mike-rankin/ESP32_CoinCell/Images/Bottom_Side.jpg

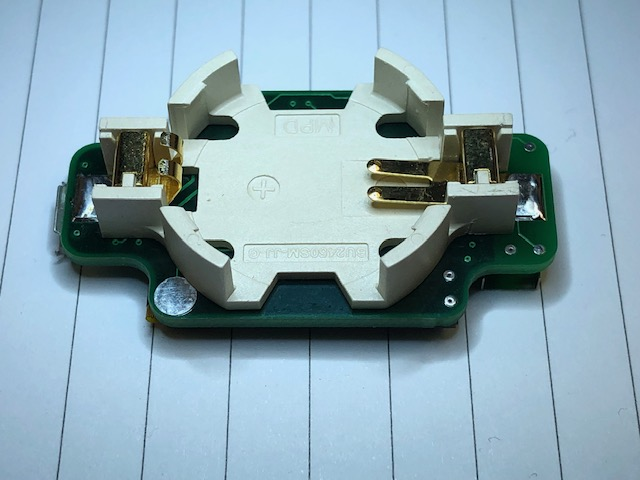
Images/Bottom_Side.jpg
