mike-rankin/ESP32_CoinCell/Images/Top.jpg

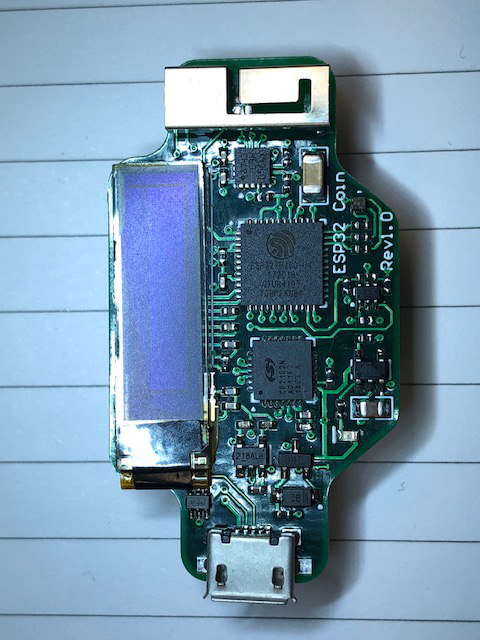
Images/Top.jpg
