mike-rankin/ESP32_CoinCell/PCB/Schematic_Rev4.pdf

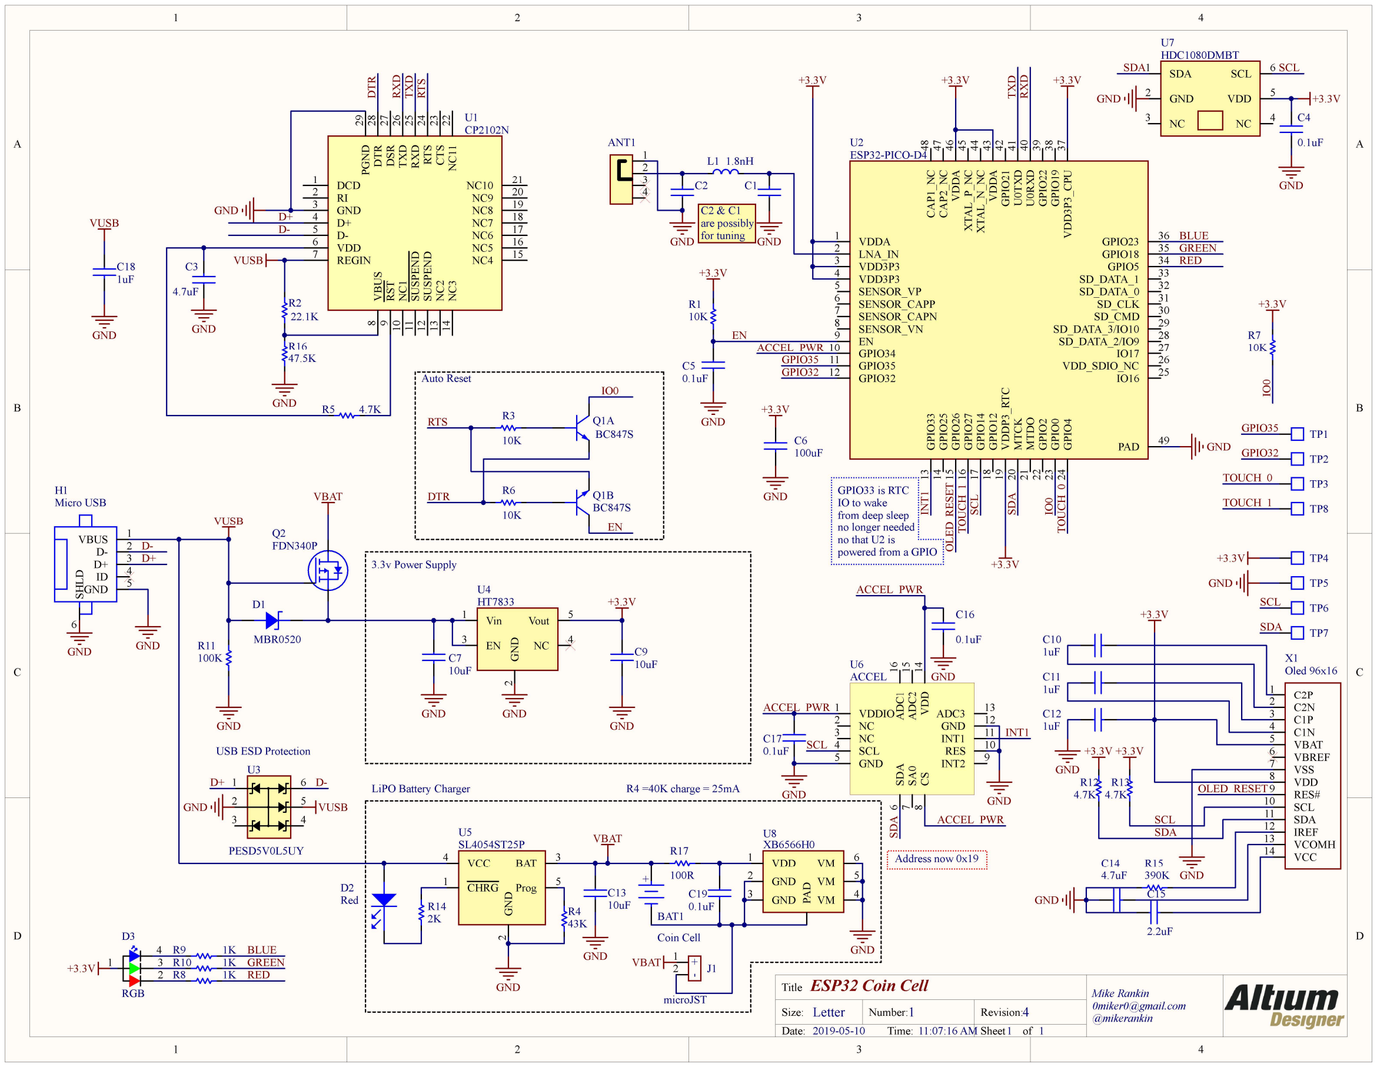
[picture p3: page 1]

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
Mike Rankin
0miker0@gmail.com
@mikerankin
1

## ESP32 Coin Cell

1 4
2019-05-10 | 11:07:16 AM

Title

Size: | Number:
Date:

Revision:
Time: | Sheet | of

Letter

+

BAT1

DCD 1

CP2102N

RI 2
GND 3
D+ 4
D- 5
VDD 6
REGIN 7 | VBUS

### 8 RST

### 9 NC1 10 SUSPEND 11 SUSPEND 12 NC2 13 NC3 14

NC4 | 15 NC5 | 16 NC6 | 17 NC7 | 18 NC8 | 19 NC9 | 20 NC10 | 21 NC¹¹ ²² CTS ²³ RTS ²⁴ RXD ²⁵ TXD ²⁶ DSR ²⁷ DTR ²⁸ PGND ²⁹ | U1

GND

10K

R3

10K

R6

D-

D+ | DTR | RTS
GND | RXD TXD

DTR

RTS

GND

VUSB

PESD5V0L5UY

1
2
3

6
5
4

U3

BC847S

Q1A

BC847S

Q1B

VUSB

GND

3.3v Power Supply

43K

R4

GND

10uF

C13

GND

2K

R14 Red

D2

GND

VBAT

LiPO Battery Charger | R4 =40K charge = 25mA

D1

MBR0520

+3.3V

VBUS | 1
D- | 2
D+ | 3
GND | 5
ID | 4

Micro USB SHLD

6

H1

GND

Coin Cell

FDN340P

Q2

VBAT

100K

R11

GND

D-D+

+3.3V | R10 | 1K
| R9 | 1K
| R8 | 1K

BLUE

1
2
3
4

ANT1

10K

R1

0.1uF

C5

GND

+3.3V

C2

GND | GND
+3.3V | +3.3V | +3.3V

+3.3V

10K

R7

+3.3V SCL | SDA | IO⁰ TXD RXD

GND

+3.3V

GND

100uF

C6

GND

GND

+3.3V

OLED_RESET

SCL
SDA

+3.3V +3.3V

C2P 1
C2N 2
C1P 3
C1N 4
VBAT 5
VBREF 6

VDD 8
RES# 9
SCL 10
SDA 11
IREF 12
VCOMH 13
VCC 14

VSS 7

X1
Oled 96x16

1uF

C10

1uF

C11

1uF

C12

4.7K

R12
4.7K

R13

390K

R15
4.7uF

C14

2.2uF

C15

VUSB | EN
IO0 | IO⁰

GND

USB ESD Protection

Auto Reset

VDDIO 1
NC 2
NC 3
SCL 4
GND 5 | SDA

### 6 SA0 7 CS

8

INT2 | 9
RES | 10 INT1 | 11 GND | 12 ADC3 | 13 VDD ¹⁴ ADC² ¹⁵ ADC¹ ¹⁶U6
ACCEL

INT1
SCL | SDA

0.1uF

C16

0.1uF

C17

GND

GND | GND

GPIO33 is RTC
IO to wake
from deep sleep
D+ | D- | TOUCH_0 OLED_RESET | TP3 TOUCH_0
+3.3V | TP4
GND | TP5
| TP6
| TP7

SCL

SDA INT¹

TP1

TP2

GPIO35
GPIO32

GPIO35

GPIO32

1

4
3
2

D3

RGB

GREEN

BLUE
GREEN

RED

RED

4.7uF

C3

R5 4.7K

22.1K

R2

47.5K

R16

GND

1uF

C18

VUSB

GND

HDC1080DMBT
SDA 1

GND 2

NC 3 | NC | 4
| SCL | 6
| VDD | 5

U7

+3.3V

0.1uF

C4

GND

GND

SDA | SCL TOUCH_1 | TP8 TOUCH_1

1
2 - +
J1

0.1uF

C19

100R

R17

VBAT

VCC 4

CHRG 1 | GND

2

BAT | 3
Prog | 5

SL4054ST25P

U5

10uF

C7 | 10uF C9
GND | GND
GND

XB6566H0
VDD 1

GND 3

GND 2 | VM | 5
| VM | 4
VM | 6 PAD

U8

EN

Address now 0x19

microJST

HT7833
Vin 1
EN 3 | GND

2

Vout | 5
NC | 4
U4 | ACCEL_PWR

ACCEL_PWR

ACCEL_PWR

ACCEL_PWR

L1 1.8nH

C1

C2 & C1
are possibly
for tuning

no longer needed
no that U2 is
powered from a GPIO

VDDA 1

PAD 49

LNA_IN 2
VDD3P3 3
VDD3P3 4
SENSOR_VP 5
SENSOR_CAPP 6
SENSOR_CAPN 7
SENSOR_VN 8
EN 9
GPIO34 10
GPIO35 11
GPIO32 12 | GPIO³³ 13 GPIO²⁵ 14 GPIO²⁶ 15 GPIO²⁷ 16 GPIO¹⁴ 17 GPIO¹² 18 VDDP³_RTC 19 MTCK 20 MTDO 21 GPIO² 22 GPIO⁰ 23 GPIO⁴ 24
IO16 | 25 VDD_SDIO_NC | 26 IO17 | 27 SD_DATA_2/IO9 | 28 SD_DATA_3/IO10 | 29 SD_CMD | 30 SD_CLK | 31 SD_DATA_0 | 32 SD_DATA_1 | 33 GPIO5 | 34 GPIO18 | 35 GPIO23 VDD³P³_CPU | 36 ³⁷ GPIO¹⁹ ³⁸ GPIO²² ³⁹ U⁰RXD ⁴⁰ U⁰TXD ⁴¹ GPIO²¹ ⁴² VDDA ⁴³ XTAL_N_NC ⁴⁴ XTAL_P_NC ⁴⁵ VDDA ⁴⁶ CAP²_NC ⁴⁷ CAP¹_NC ⁴⁸U2
ESP32-PICO-D4
