mike-rankin/ESP32_CoinCell/Images/Bottom.jpg

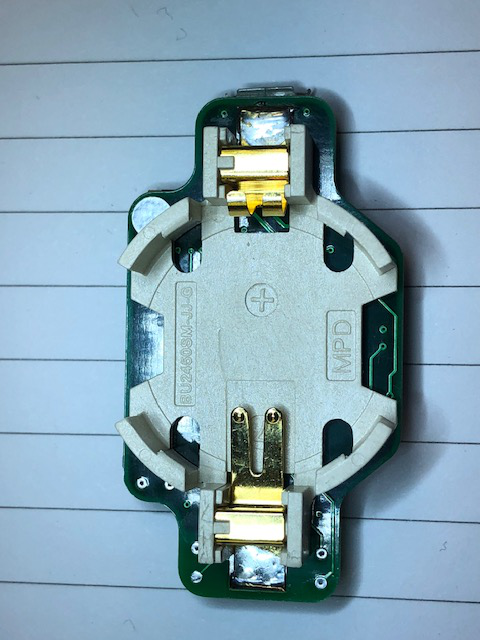
Images/Bottom.jpg
