mike-rankin/ESP32_CoinCell/Images/Exposed_GPIO_Pads.jpg

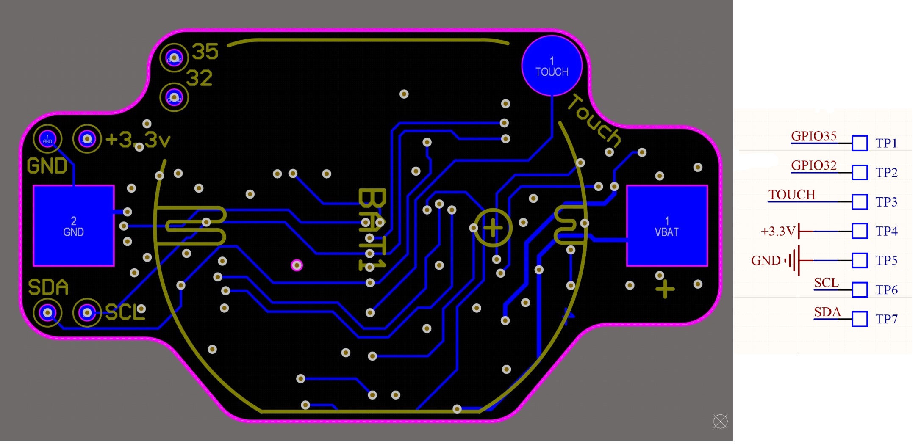
Images/Exposed_GPIO_Pads.jpg
