mike-rankin/ESP32_CoinCell/Images/Rev4.jpg

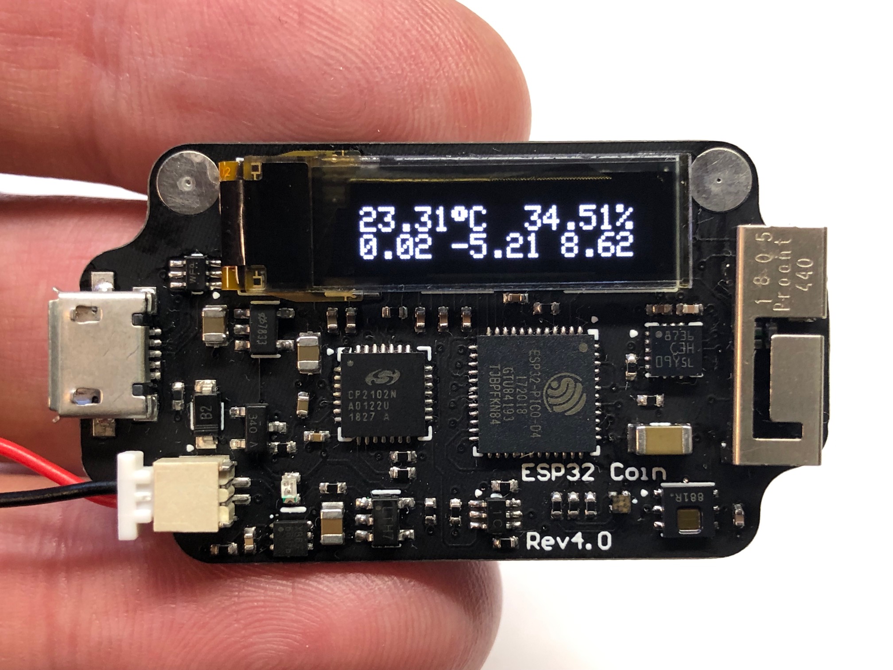
Images/Rev4.jpg
