mike-rankin/ESP32_CoinCell/Images/Top_Side.jpg

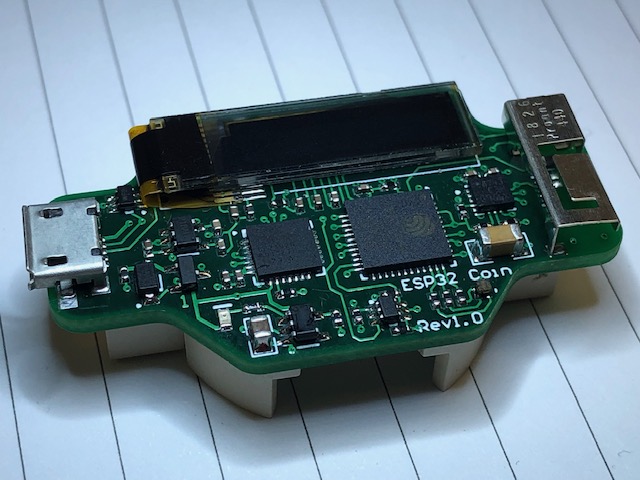
Images/Top_Side.jpg
