mike-rankin/ESP32_CoinCell/PCB/Parts_List_Rev4.xls

Designator | Quantity | Vendor | PartNumber | Description | Manufacturer | Value
ANT1 | 1 | Digi-Key | PRO-OB-440 | RF ANT 2.4GHZ STAMPED MET SLD | Proant AB | RF ANT 2.4GHZ
BAT1 | 1 | LCSC | BU2450SM-JJ-GTR | HOLDER,BATT,COIN,24.5MM,SMT | MPD | Coin Cell Holder
C3, C14 | 2 | LCSC | CM05X5R475M16AH | CAP CER 4.7uF 16V 0402 | Kyocera | 4.7uF
C4, C5, C16, C17, C19 | 5 | LCSC | TCC0402X5R104M160AT | CAP CER 0.1uF 16V 0402 | CCTC | 0.1uF
C6 | 1 | LCSC | JMK316BJ107ML-T | CAP CER 100uF 6.3V 1206 | Taiyo Yuden | 100uF
C7, C9 | 2 | LCSC | GRM21BB31C106KE15L | CAP 10uF 0805 | Murata | 10uF
C10, C11, C12, C18 | 4 | LCSC | GRM155R61C105KA12D | CAP CER 1uF 16V 0402 | Murata | 1uF
C13 | 1 | LCSC | CL21A106KOQNNNG | CAP CER 10uF 16V 0805 | Samsung | 10uF
C15 | 1 | LCSC | CL05A225KO5NQNC | CAP CER 2.2uF 16V 0402 | Samsung | 2.2uF
D1 | 1 | LCSC | MBR0520 | DIODE SCHOTTKY 20V 500MA SOD123 | CJ | MBR0520
D2 | 1 | LCSC | FC-DA1608HRK-620D | LED RED CLEAR 0603 SMD | FNO | Red
D3 | 1 | LCSC | FC-B1010RGBT-HG | LED,RGB LED,SMD,RoHS | Foshan | RGB Led
H1 | 1 | LCSC | C21377 | CONN RCPT MICRO USB TYPE AB | REG CON | Micro USB
L1 | 1 | LCSC | BKW0603UC1N8KGT | Inductor 1.8nH 0402 | GFBE | 1.8nH
Q1 | 1 | LCSC | BC847S | TRANS 2NPN 44V 0.1A SC-70-6 | Changjiang | 2NPN
Q2 | 1 | LCSC | FDN340P | MOSFET P-CH 20V 2A SOT-23 | On Semi | Mosfet P-H
R1, R3, R6, R7 | 4 | LCSC | RC-02W1002FT | RES SMD 10K OHM 0402 | Guangdong | 10K
R2 | 1 | LCSC | RC0402FR-0722K1L | RES SMD 22.1K OHM 0402 | Yageo | 22.1K
R4 | 1 | LCSC | 0402WGF4302TCE | RES SMD 43K OHM 0402 | Uniroyal | 43K
R5, R12, R13 | 3 | LCSC | RC0402FR-074K7L | RES SMD 4.7K OHM 0402 | Yageo | 4.7K
R8, R9, R10 | 3 | LCSC | RC0402FR-071KL | RES SMD 1K OHM 0402 | Yageo | 1K
R11 | 1 | LCSC | 0402WGF1003TCE | RES SMD 100K OHM 0402 | Uniroyal Elec | 100K
R14 | 1 | LCSC | CR0402FF2001G | RES SMD 2K OHM 1% 1/10W 0402 | LIZ Elec | 2K
R15 | 1 | LCSC | RC-02W3903FT | RES SMD 390K OHM 0402 | Guangdong | 390K
R16 | 1 | LCSC | RC0402FR-0747K5L | RES SMD 47.5K OHM 0402 | Yageo | 47.5K
R17 | 1 | LCSC | RC0402FR-07100RL | RES SMD 100R OHM 1% 1/10W 0402 | Yageo | 100R
U1 | 1 | LCSC | CP2102N-A01-GQFN28 | IC BRIDGE USB TO UART 28QFN | Silicon Labs | CP2102N
U2 | 1 | LCSC | ESP32-PICO-D4 | RF Transceiver ICs QFN-48 | Espressif | ESP32-PICO-D4
U3 | 1 | LCSC | PESD5V0L5UY | TVS SOT-363 RoHS | Yenji | ESD
U4 | 1 | LCSC | HT7833 | IC LDO 3.3V 0.5A SOT23-5 | Holtek | LDO 3.3V
U5 | 1 | LCSC | SL4054ST25P | Charger IC Lithium-Ion/Polymer SOT23-5 | Techfuse | SL4054ST25P
U6 | 1 | LCSC | LIS3DHTR | IC ACCEL 2-16G I2C/SPI 16LGA | STMicro | LIS3DHTR
U7 | 1 | LCSC | HDC1080DMBT | Humidity/Temperature Sensor | Texas Instruments | Humidity/Temperature
U8 | 1 | LCSC | XB6566H0 | IC Battery Protection | XySemi | Battery Protection
X1 | 1 | Buy-Display | ER-OLED0.69-1W | 96x16 OLED_GLASS | N/A
