mike-rankin/ESP32_CoinCell/PCB/Schematic_Rev1.pdf

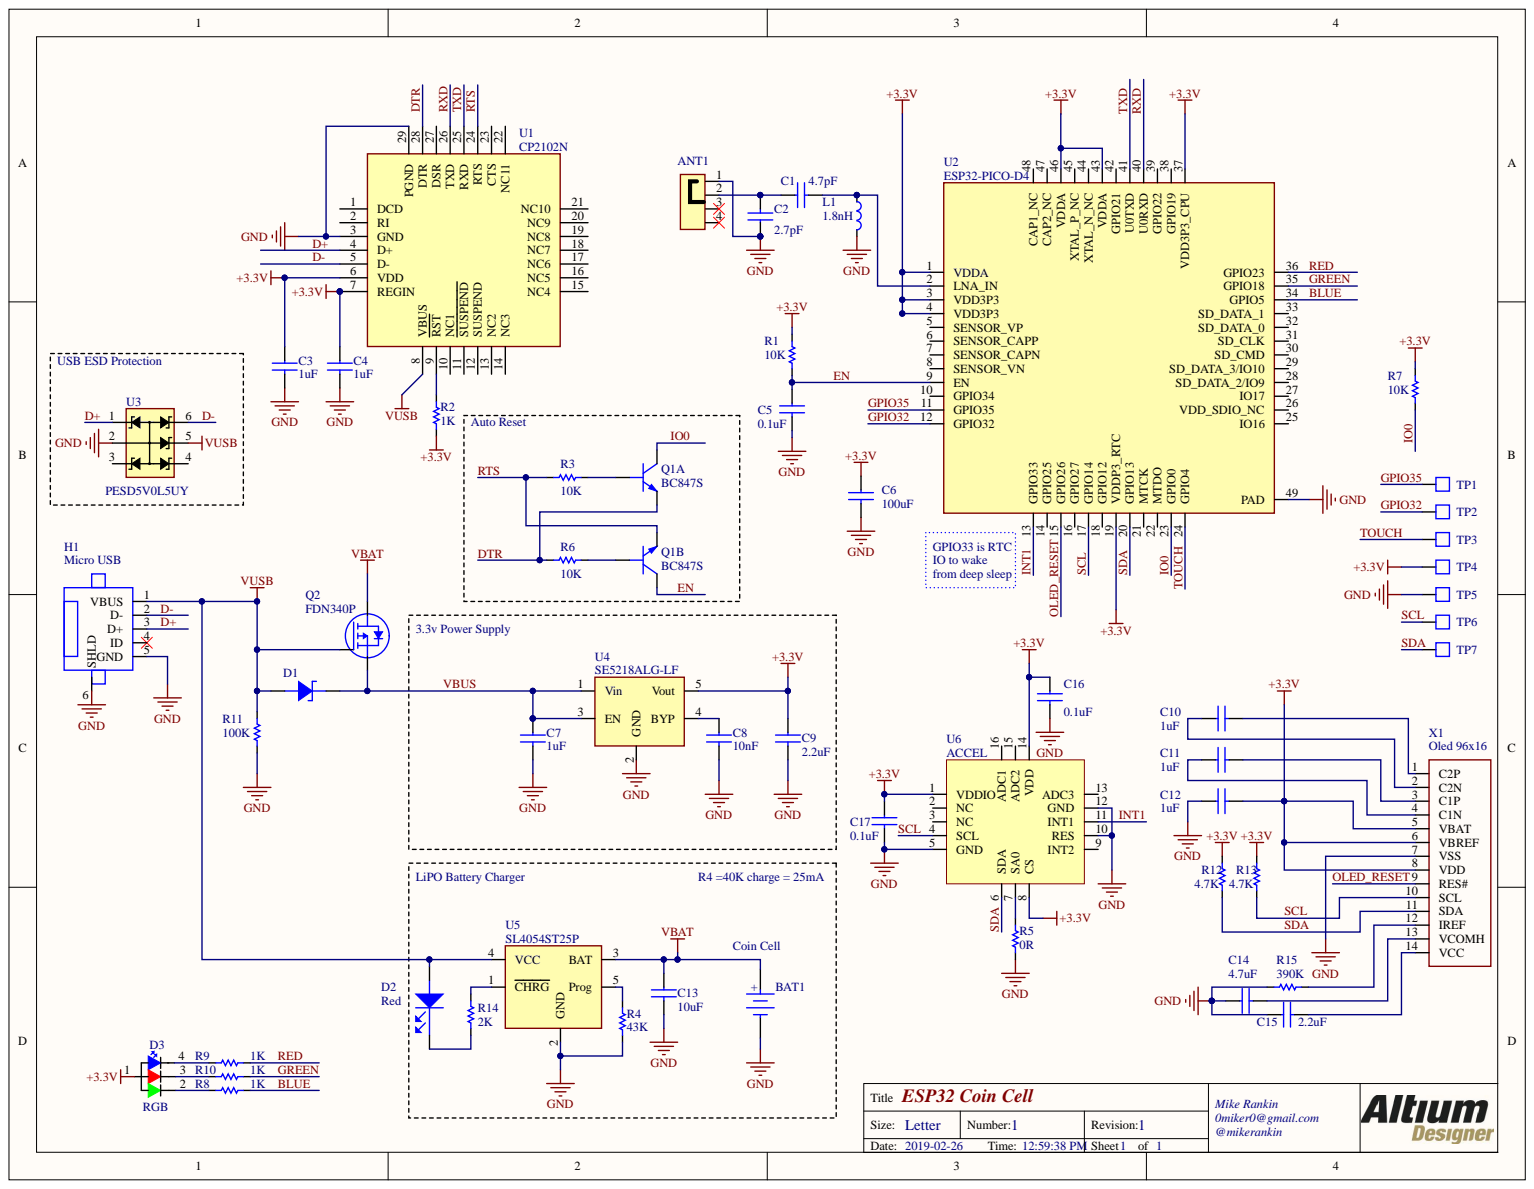
[picture p8: page 1]

NC11 22 CTS 23 RTS 24 RXD 25 TXD 26 DSR 27 DTR 28 PGND 29

Micro USB SHLD 6 H1GND

3.3v Power Supply | U 4 +3.3V D

VBU S | 1

LiPO Battery Charger | R4 =40K charge = 25mA SL4054ST25P U5 VBAT 4

OLED_RESET 9

Title | Mike Rankin 0miker0@gmail.com @mikerankin

Size: Letter | Number: | Revision: 1

Date: 2019-02-26 Time: 12:59:38 PM | | Sheet 1 of 1
