mike-rankin/ESP32_CoinCell/(list of files, drawings)

Other design files:
PCB/PCB_Library.PcbLib
PCB/Schematic_Library.SCHLIB
