mike-rankin/ESP32_CoinCell/(threads)

Thread 1 (2019-02-25):

Datasheets

NikolaiRuhe, 2019-02-25:
Great Project, thanks for sharing!

How did you select components, like the LiPo charger (SL4054ST25P) or LDO (SE5218ALG-LF)? I see them listed on LCSC but can’t find any datasheet.

mike-rankin, 2019-02-25:
LCSC has datasheets for every part on their web site. I use chrome and they all are there.

Closed 2019-04-18.

Thread 2 (2019-05-18):

Board Settings - Rev4

ohararp, 2019-05-18:
Mike, can you provide the Board settings for the Rev4 Configuration?

mike-rankin, 2019-05-21:
Under Tools/Board choose ESP32 Dev module. All other settings are left to default.

Thread 3 (2025-04-08):

Question on the LDO

stelioskat, 2025-04-08:
Hey Mike!

If I understand it properly you feed the 3.6V battery voltage into the LDO HT7833. According to the datasheet, this LDO has a minimum supply voltage of 4.75V; much higher than our 3.6V.

Did you have any issues with this setup? Am I somehow mistaken? Thank you in advance!

mike-rankin, 2025-04-08:
LCSC sells the HT7833 from different manufacturers and the datasheet I see here does not mention the 4.75V minimum supply voltage. It still could be operating out of spec but 3.6V in of the LDO outputs 3.3V on my board without issue.

stelioskat, 2025-04-08:
I appreciate your quick response.

Apparently I managed to stumble upon the only datasheet, that gives this spec of minimum 4.75V haha https://www.farnell.com/datasheets/4419372.pdf .
I saw now too that other manufactures don't give a bottom limit.

Closed 2025-04-08.
