mike-rankin/ESP32_CoinCell/Code/Low_Power_Time.ino

/*
The ESP32 Coin Cell Board uses Tools/Board/ESP32 Dev Module
Simple Deep Sleep with Timer Wake Up Displaying Time every 10 minutes

Using the Arduino IDE choose Tools/Board: ESP32 Dev Module
=====================================

This code is under Public Domain License.

Original Author:
Pranav Cherukupalli <cherukupallip@gmail.com>
*/

#include <WiFi.h>
#include <Wire.h>
#include "time.h"
#include <Adafruit_GFX.h>
#include <Adafruit_SSD1306.h>
#include <Adafruit_LIS3DH.h>
#include <Adafruit_Sensor.h>

#define uS_TO_S_FACTOR 1000000   /* Conversion factor for micro seconds to seconds */
#define TIME_TO_SLEEP  60        /* Time ESP32 will go to sleep (in seconds) 600 = 10 minutes */  
#define OLED_RESET 26             /*ESP32 Pico D4 */

#define RED_LED 23  //lights Green
#define GREEN_LED 18  //lights Red
#define BLUE_LED 5

//#define SCREEN_HEIGHT 16
//#define SCREEN_WIDTH  96

#define LOGO_HEIGHT   16
#define LOGO_WIDTH    96 

static const unsigned char PROGMEM logo_bmp[] =
{ 
    0x00, 0x00, 0x00, 0x00, 0x00, 0x00, 0x00, 0x00, 0x00, 0x00, 0x00, 0x00, 
    0x00, 0x00, 0x00, 0x00, 0x00, 0x00, 0x00, 0x00, 0x00, 0x00, 0x00, 0x00, 
    0x00, 0x00, 0x00, 0x00, 0x00, 0x00, 0x00, 0x00, 0x00, 0x00, 0x00, 0x00, 
    0x00, 0x00, 0x00, 0x00, 0x00, 0x00, 0x00, 0x00, 0x00, 0x00, 0x00, 0x00, 
    0x03, 0xf3, 0xff, 0x18, 0xe0, 0x1e, 0x01, 0x80, 0x1e, 0x03, 0xb8, 0x00, 
    0x01, 0x94, 0x59, 0xac, 0xb0, 0x32, 0x00, 0x00, 0x32, 0x01, 0x98, 0x00, 
    0x01, 0x87, 0x19, 0x8c, 0x30, 0x60, 0x33, 0xb4, 0x60, 0x31, 0x98, 0x00, 
    0x01, 0xe3, 0xdf, 0x18, 0x60, 0x60, 0x69, 0x9a, 0x60, 0x69, 0x98, 0x00, 
    0x01, 0x80, 0xd8, 0x0c, 0x40, 0x60, 0x69, 0x9a, 0x60, 0x79, 0x98, 0x00, 
    0x01, 0x94, 0x58, 0x2c, 0x90, 0x26, 0x69, 0x9a, 0x26, 0x61, 0x98, 0x00, 
    0x03, 0xf7, 0xbc, 0x18, 0xf0, 0x1c, 0x33, 0xfb, 0x1c, 0x3b, 0xfc, 0x00, 
    0x00, 0x00, 0x00, 0x00, 0x00, 0x00, 0x00, 0x00, 0x00, 0x00, 0x00, 0x00, 
    0x00, 0x00, 0x00, 0x00, 0x00, 0x00, 0x00, 0x00, 0x00, 0x00, 0x00, 0x00, 
    0x00, 0x00, 0x00, 0x00, 0x00, 0x00, 0x00, 0x00, 0x00, 0x00, 0x00, 0x00, 
    0x00, 0x00, 0x00, 0x00, 0x00, 0x00, 0x00, 0x00, 0x00, 0x00, 0x00, 0x00, 
    0x00, 0x00, 0x00, 0x00, 0x00, 0x00, 0x00, 0x00, 0x00, 0x00, 0x00, 0x00
   
};

Adafruit_SSD1306 display(96, 16, &Wire, 26);

const char* ssid       = "SSID";
const char* password   = "PASSWORD";

const char* ntpServer = "pool.ntp.org";
const long  gmtOffset_sec = -14400;
const int   daylightOffset_sec = 3600;

RTC_DATA_ATTR int bootCount = 0;


struct tm timeinfo;

void setup()
{
  Serial.begin(9600);
  delay(1000); 

  pinMode(OLED_RESET, OUTPUT);
 
  pinMode(RED_LED, OUTPUT);
  pinMode(GREEN_LED, OUTPUT);
  pinMode(BLUE_LED, OUTPUT);
 
  digitalWrite(OLED_RESET, HIGH);   //Keep Oled High = 0.21mA, OLED_RESET LOW draws lots of current

  digitalWrite(RED_LED, HIGH);   //Keep Led off
  digitalWrite(GREEN_LED, HIGH); //Keep Led off
  digitalWrite(BLUE_LED, HIGH);  //Keep Led off

  Wire.begin(13,14);  //ESP32 Pico D4 pins
  display.setRotation(2);
  display.begin(SSD1306_SWITCHCAPVCC, 0x3C); 

   //connect to WiFi
  Serial.printf("Connecting to %s ", ssid);
  WiFi.begin(ssid, password);
  while (WiFi.status() != WL_CONNECTED) {
      delay(500);
      Serial.print(".");
  }
  Serial.println(" CONNECTED");
  digitalWrite(GREEN_LED, LOW);
  delay(150);
  digitalWrite(GREEN_LED, HIGH);
  
  testdrawbitmap();
  //display.display();
  delay(2000);
  display.clearDisplay();

  //init and get the time
  configTime(gmtOffset_sec, daylightOffset_sec, ntpServer);

  esp_sleep_enable_timer_wakeup(TIME_TO_SLEEP * uS_TO_S_FACTOR);
  Serial.println("Setup ESP32 to sleep for every " + String(TIME_TO_SLEEP) +
  " Seconds");
}

void loop()
{
   struct tm timeinfo;
  if(!getLocalTime(&timeinfo))
  {
    Serial.println("Failed to obtain time");
    return;
  }

  digitalWrite(RED_LED, LOW);  //LED on
  delay(100);
  digitalWrite(RED_LED, HIGH);
  delay(100);

  digitalWrite(GREEN_LED, LOW);  //LED on
  delay(100);
  digitalWrite(GREEN_LED, HIGH);
  delay(100);

  digitalWrite(BLUE_LED, LOW);
  delay(100);
  digitalWrite(BLUE_LED, HIGH);
  delay(100);

  display.ssd1306_command(SSD1306_DISPLAYON);
  
  display.setTextSize(1);
  display.setTextColor(WHITE);
  display.setCursor(0,0);  //over,down
  Serial.println(&timeinfo, "%A, %B %d %Y %H:%M:%S");
  display.println("NTP Time:");
  display.println(&timeinfo, "%H:%M:%S");
  display.display();
  delay(2000);
  display.clearDisplay();

  display.ssd1306_command(SSD1306_DISPLAYOFF);

  Serial.println("Going to sleep now");
  esp_deep_sleep_start();
}

void testdrawbitmap(void)
{
  display.clearDisplay();

  display.drawBitmap(
    (display.width()  - LOGO_WIDTH ) / 2,
    (display.height() - LOGO_HEIGHT) / 2,
    logo_bmp, LOGO_WIDTH, LOGO_HEIGHT, 1);
  display.display();
  delay(2000);
  display.clearDisplay();
}
