mike-rankin/ESP32_CoinCell/(commit log)

2019-02-09 Updated BOM
    [Parts_List.xls]
2019-02-10 Updated charge resistor value
    [Parts_List.xls]
2019-02-16 updated Parts List
    [Parts_List.xls]
2019-02-16 Added Low Power Test Code
2019-02-17 Updated Low Power Code
2019-02-17 Corrected schematic
2019-02-26 Corrected scheamtic, added touch sketch
    [Parts_List.xls]
2019-04-17 Added Rev4 files
    [Parts_List_Rev1.xls, Parts_List_Rev4.xls]
2019-04-18 updated schematic and code Board instructions
    [Parts_List_Rev4.xls]
2019-05-10 Corrected schematic and added parts libraries
    [PCB_Library.PcbLib, Schematic_Library.SCHLIB]
